ZacVawter/cycle_foot/cad/cycle_foot.FCStd

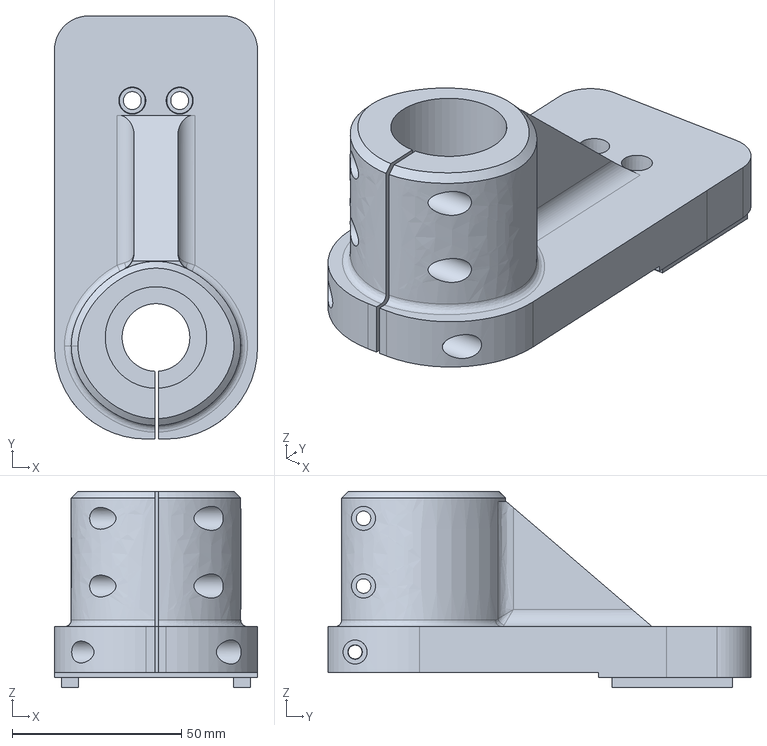
[picture p4: CAD file, 2026-11-09]
cad/cycle_foot.FCStd
60.0 x 125.0 x 58.0 mm
