ZacVawter/cycle_foot/exports/step/cycle_foot-sole.step

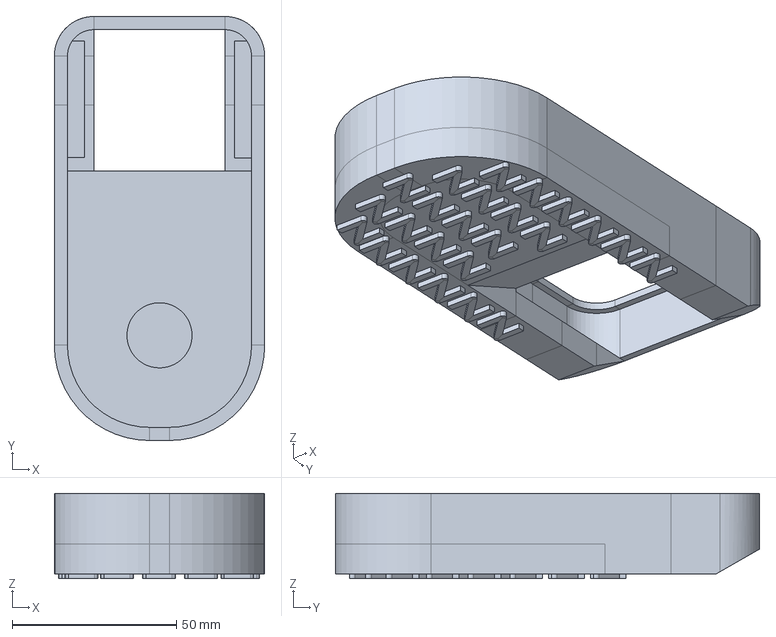
[picture p5: CAD file, 2026-05-19]
exports/step/cycle_foot-sole.step
64.0 x 129.0 x 26.0 mm
