ZacVawter/cycle_foot/(list of files, cad)

Other CAD files:
exports/step/cycle_foot-foot.step
exports/stl/cycle_foot-foot.stl
exports/stl/cycle_foot-sole.stl
