ZacVawter/cycle_foot/(commit log)

2023-10-29 v0: first CAD model of the cycle foot
    Modelled after the hand-cut ABS prototypes (V0.1-V0.5), which showed:
    - The vertical load path is critical; get it wrong and it breaks.
    - Side ribs must carry load into the pedal so it doesn't all go
    through the cleat; this allows side-to-side motion without unclipping.
    - Pylon-to-cleat distance decides whether the rider can unlock their knee.
    [cycle_foot-foot.step, cycle_foot-foot.stl]
2023-10-29 v1: machined Delrin foot
    First machined version, with an FEM load study.
    Lessons learned:
    - Cleat-to-toe (15 mm) too short: OK for Crank Brothers Egg Beaters,
    not SPD; the edge deformed after a few rides.
    - Lengthen pylon-to-cleat 5-10 mm (from 60 mm) for easier knee unlock.
    - Use standard cleat hole spacing.
    - Add a replaceable 3D-printed wear plate under the foot.
    - Use threaded inserts from the top for the cleat bolts.
    [cycle_foot-foot.step, cycle_foot-foot.stl]
2023-11-01 v2: threaded inserts and separate printed sole
    - Heat-set threaded inserts for M4 cleat bolts.
    - New separate sole: a replaceable wear plate covering the bottom of
    the foot, which can use a more compliant material for clipping in.
    [cycle_foot-foot.step, cycle_foot-foot.stl, cycle_foot-sole.step, cycle_foot-sole.stl]
2023-11-01 v3: minor foot revision
    Small geometry adjustment to the foot; sole unchanged.
    [cycle_foot-foot.step, cycle_foot-foot.stl, cycle_foot-sole.step]
2023-11-03 v3.1: parametric rework
    - Rebuilt around a Parameters spreadsheet: pylon diameter 30 mm,
    pylon-to-cleat 70 mm, cleat-to-toe 25 mm.
    - Pockets sized for E-Z LOK tapered inserts.
    - Sole unchanged.
    [cycle_foot-foot.step, cycle_foot-foot.stl]
2023-11-11 v3.5: pylon tube clamp and new sole
    - Three-bolt pylon tube clamp (bolts at 7.5, 27 and 47 mm).
    - Added M3 tapered inserts alongside the M4 cleat inserts.
    - Sole remodelled (64 x 129 mm).
    [cycle_foot-foot.step, cycle_foot-foot.stl, cycle_foot-sole.step, cycle_foot-sole.stl]
2023-11-13 v3.5: adjustments for 3D printing
    Print-ready version of the v3.5 foot.
    [cycle_foot-foot.step, cycle_foot-foot.stl, cycle_foot-sole.step, cycle_foot-sole.stl]
2024-01-06 v3.6: revised sole
    [cycle_foot-foot.step, cycle_foot-sole.step, cycle_foot-sole.stl]
2026-05-19 v3.7: stronger tube clamp, more sole grip
    - Removed the sole bolt-on holes.
    - Strengthened the tube clamp.
    - Tube clamp slot is now a printable feature.
    - More Z-shaped grip patterns on the sole.
    Adds the parametric FreeCAD source (cad/cycle_foot.FCStd), including the
    CalculiX FEM analysis.
    [cycle_foot-foot.step, cycle_foot-foot.stl, cycle_foot-sole.step, cycle_foot-sole.stl, cycle_foot.FCStd]
2026-11-08 README: printing & setup guide, tested materials and hardware
    - Emphasise print quality in the safety notice.
    - Add tested filaments (Bambu PA6-CF, PAHT-CF) with a tensile-strength
    rule of thumb, print settings and orientation.
    - Add heat-set insert installation steps with McMaster part numbers,
    clamp bolts and Crankbrothers Shoe Shield.
    - Correct insert labels in the design history (cleat inserts are M5).
2026-11-09 README: add renderings, TPU sole, three-bolt clamp
    - Add top and bottom renderings.
    - Sole is printed in TPU to protect the bike and grip when walking.
    - Pylon clamp uses three M4 inserts and bolts.
    - Warn not to drill the insert holes.
2026-11-09 Move design details into DESIGN.md
    - Repository layout, parts, parameters and the design history move out of
    the README into DESIGN.md, so the README focuses on printing and fitting.
    - Add an FEA section: current setup, last results, and how to re-run
    after a design or material change.
    - Merge docs/design-history.md into DESIGN.md as Requirements and
    Previous learnings.
2026-11-09 FEA: rerun at 3000 N design load on a fresh mesh
    - Load corrected to 3000 N (ISO 4210-8 pedal test 1500 N x 2 safety
    factor). The old value was read by FreeCAD 1.x as 0.5 N.
    - Regenerated the Gmsh mesh for the v3.7 geometry (the stored mesh was
    from older geometry) with SecondOrderLinear to avoid inverted elements.
    - DESIGN.md: load case, results by region, how to read them, limits,
    re-run steps, and a warning about force units.
    [cycle_foot.FCStd]
2026-11-09 Docs: frame design changes as optional; rename to Design parameters
2026-11-09 README: correct cleat mount location in intro
2026-11-09 Soften claims, encourage validation, restore official licence text
    - LICENSE: restore the official CERN-OHL-S v2 text verbatim (section 3
    heading capitalisation and 'licence' in 7.1).
    - Material guidance framed as what has worked for one rider; ask users to
    do their own validation.
    - FEA results presented as indicative, not a demonstrated safety factor;
    remove claims that the low modulus is conservative and that inserts
    reduce hole stress; add a Validation section (static and fatigue tests).
    - Qualify Total Knee fit and frame-protection statements.
    - Welcome further and academic design analysis.
    - 'daily use' -> 'regular use'.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
2026-11-09 README: note riding record spans three prints and minor revisions
2026-11-09 README: remove E-Z LOK insert link
2026-11-09 README: add print file links and Sole TPU material
2026-11-09 README: note on clearing the bridged clamp slot after printing
